nicolacimmino/TRNG/documentation/distribution.png

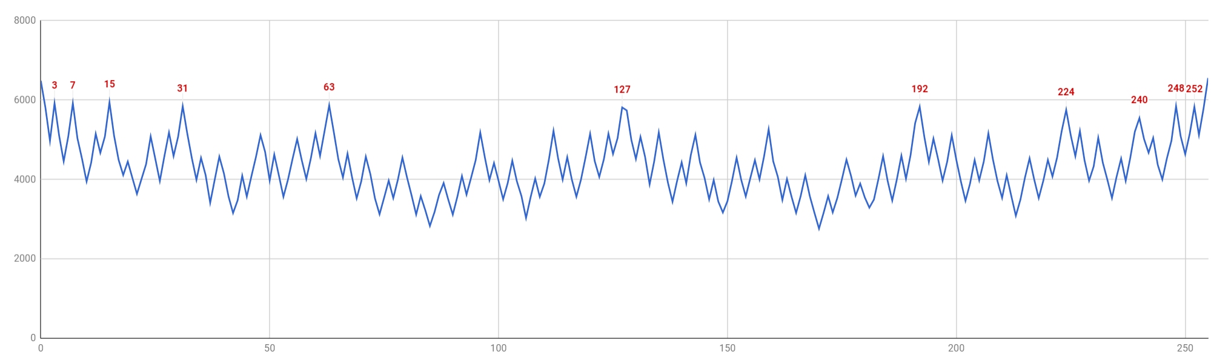
documentation/distribution.png
