nicolacimmino/TRNG/documentation/distribution_good.png

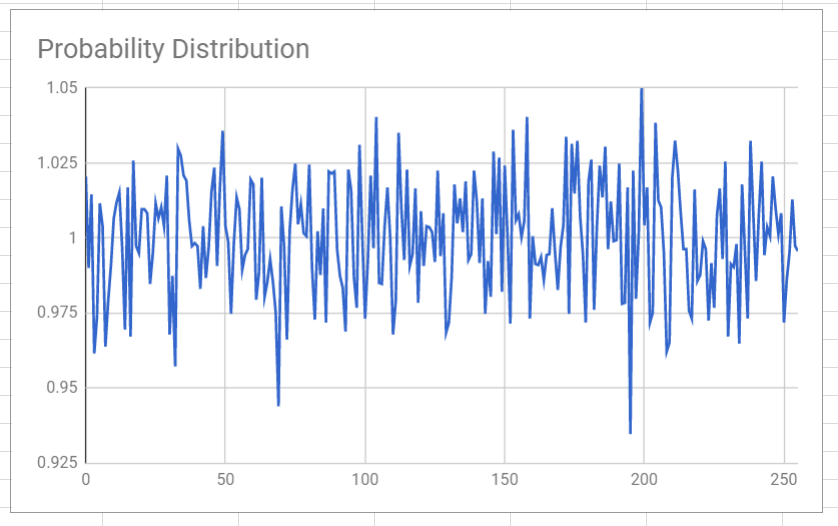
documentation/distribution_good.png
