nicolacimmino/TRNG/documentation/proto.png

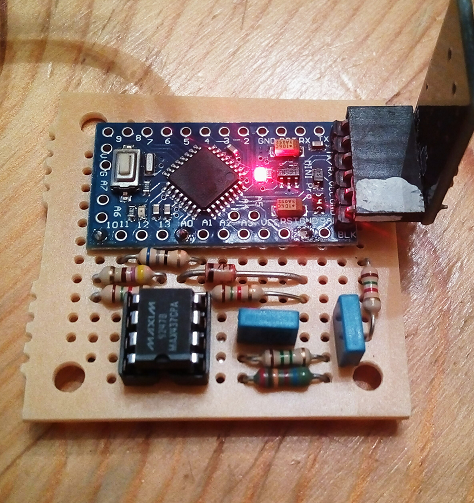
documentation/proto.png
