nicolacimmino/TRNG/documentation/schematic.png

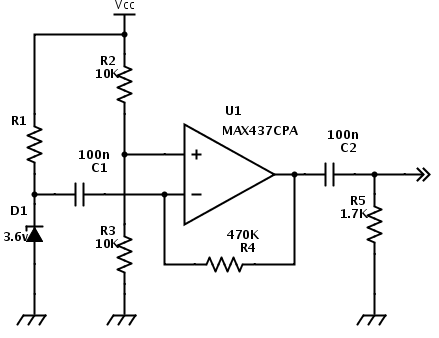
documentation/schematic.png
