nicolacimmino/TRNG/TRNG.ino

// TRNG implements a true random numbers generator.
//  Copyright (C) 2018 Nicola Cimmino
//
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

#define PIN_NOISE_IN A0

unsigned int outputSpeedbps = 0;

/*
 * Arduino setup.
 */
void setup()
{
  Serial.begin(115200);

  initDisplay();

  performPost();

  initPrimaryNoiseSource();
  initSecondaryNoiseSource();
}

/*
 * Arduino main loop.
 */
void loop()
{
  runPrimaryNoiseSource();
}

/*
 * A random number from the primary source is ready. 
 * We feed this into the randomness extractor entropy pool.
 */
void primaryRandomNumberReady(uint8_t primaryRandomNumber)
{
  randomnessExtractorCollectEntropy(primaryRandomNumber);
}

/*
 * A random number from the secondary source is ready. 
 * We feed this into the randomness extractor key entropy pool.
 */
void secondaryRandomNumberReady(uint8_t secondaryRandomNumber)
{
  randomnessExtractorCollectKeyEntropy(secondaryRandomNumber);
}

/*
 * A random number from the randomness extraxtor is ready.
 * This is our final output.
 */
void extractedRandomnessReady(uint8_t extracredRandomNumber)
{
  outputDataHex(extracredRandomNumber);
}

/**
 * Invoked every 640mS by the SecondaryNoise source time base generator. 
 */
void timeBaseTick()
{
  refreshDisplay();
}

/*
 * Output data as two digits HEX, dot separated with 32 bytes per line.
 */
void outputDataHex(byte randomNumber)
{
  uint8_t static outputBytes = 0;
  unsigned long static lastStatTime = millis();

  Serial.print("0123456789ABCDEF"[(randomNumber >> 4) & 0xF]);
  Serial.print("0123456789ABCDEF"[randomNumber & 0xF]);
  Serial.print((outputBytes % 32 == 31) ? "\n" : ".");
  outputBytes++;

  if (outputBytes % 64 == 63)
  {
    outputSpeedbps = 8 * 64000 / (millis() - lastStatTime);
    lastStatTime = millis();
  }
}
