nicolacimmino/TRNG/src/SecondaryNoiseSource.cpp

// Secondary noise source pulls 32 bits of entropy from the internal time jitter.
//
//  Copyright (C) 2019 Nicola Cimmino
//
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

#include "SecondaryNoiseSource.h"

SecondaryNoiseSource::SecondaryNoiseSource()
{
    // Setup a watchdog interrupt every 64mS.
    cli();
    _WD_CONTROL_REG = (1 << WDCE) | (1 << WDE);
    _WD_CONTROL_REG = (1 << WDIE) | (1 << WDP1);
    sei();
}

SecondaryNoiseSource *SecondaryNoiseSource::theInstance = NULL;

SecondaryNoiseSource *SecondaryNoiseSource::instance()
{
    if (!theInstance)
    {
        theInstance = new SecondaryNoiseSource();
    }

    return theInstance;
}

/**
 * If your project is using the ISR you will get compilation errors.
 * Define __TRNG_ISR_GLOBAL_DEFINED__ and copy the body below into your global ISR function.
 */
#ifndef __TRNG_ISR_GLOBAL_DEFINED__

/**
 * This is the Arduino Interrupt Service Routine, which will be 
 * called by the WDT interrupt every 64ms.
 */
ISR(WDT_vect)
{
    SecondaryNoiseSource::instance()->collectSecondaryNoise();
}

#endif

/**
 * This is called by an ISR driven by the timer and collects at every round
 * one bit of entropy. We sample here the current value of the LSB of Timer1 
 * counter. The jitter of the interrupt process makes this random. 
 */
void SecondaryNoiseSource::collectSecondaryNoise()
{
    static uint32_t noiseBuffer = 0;
    static uint8_t collectedBits = 0;

    noiseBuffer = (noiseBuffer << 1) | (TCNT1L & 1);
    collectedBits++;

    if (collectedBits == 32)
    {
        this->createSecondaryRandomNumber(noiseBuffer);
        collectedBits = 0;
    }
}

/**
 * We pass here the collected 32 bits into a CRC-32, note that this
 * CRC-32 is forever running so it acts as randomness extrector and
 * de-bias of the input source.
 */
void SecondaryNoiseSource::createSecondaryRandomNumber(uint32_t noiseBuffer)
{
    this->crc.update(noiseBuffer);

    uint32_t crc = this->crc.finalize();

    for (int ix = 0; ix < 4; ix++)
    {
        this->randomData[ix] = crc & 0xFF;
        crc = crc >> 8;
    }

    this->randomDataReady = true;
}

bool SecondaryNoiseSource::isRandomDataReady()
{
    return this->randomDataReady;
}

uint8_t *SecondaryNoiseSource::getRandomData()
{
    this->randomDataReady = false;

    return this->randomData;
}
