nicolacimmino/TRNG/(commit log)

2014-11-26 Increased sample rate and added bias test
2014-11-26 Added schematic
2014-11-29 Cleanup and lengthened the average filter
2014-12-12 Added schematic and scope capture
2015-02-01 Updated schematic
2017-12-14 Update schematic
2017-12-16 Add igtignore, add schematic files
    [trng.kicad_pcb, trng.sch]
2018-04-21 Update schematics, better generation code
    [trng.sch]
2018-04-21 Add distribution graph, disable ADC clock precaler
2018-04-24 Fix stupid error on bitstream extraction, refactor and remove test code
    [TRNG.ino]
2018-05-13 Add secondary noise source, randomness extractor, refactor into modules
    [ChargePump.ino, PrimaryNoiseSource.ino, RandomnessExtractor.ino, SecondaryNoiseSource.ino, TRNG.ino]
2018-08-04 Move files aroumd, change serial to output raw data, fix validation tools to work with raw data
    [ChargePump.ino, PrimaryNoiseSource.ino, RandomnessExtractor.ino, SecondaryNoiseSource.ino, TRNG.ino]
2019-05-24 Fix issue with only 2 bytes of secondary entropy being used at a time
    [TRNG.cpp]
